wicware/multitool/00-documentation/02-img/glitch-voltage.png

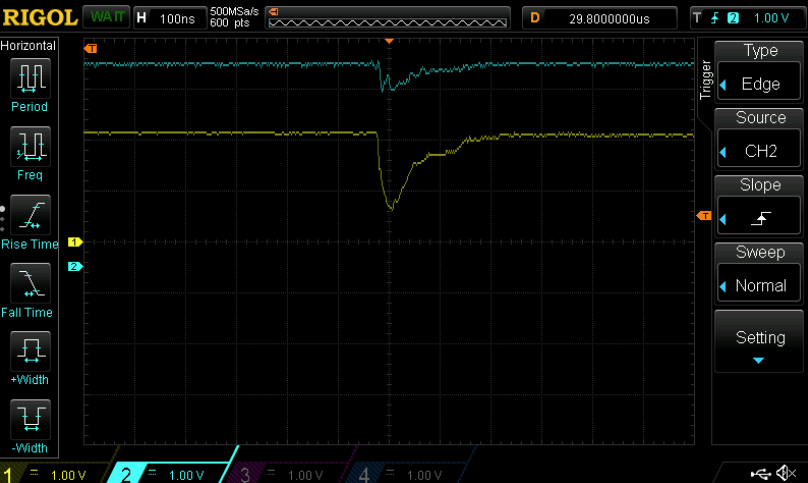
00-documentation/02-img/glitch-voltage.png
