wicware/multitool/00-documentation/image-1.png

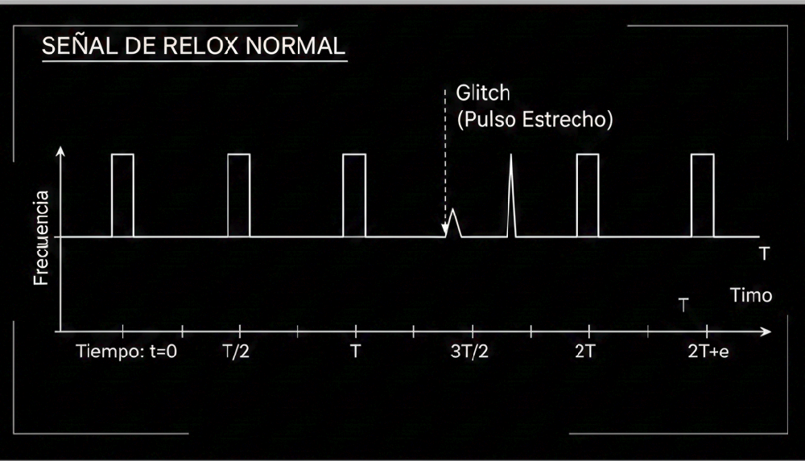
00-documentation/image-1.png
