wicware/multitool/02-hardware/FABRICATION/Sample-BOM_JLCSMT.xlsx

Comment | Designator | Footprint | JLCPCB Part #（optional）
47uF | C1 | Capacitor_SMD:C_1206_3216Metric
47uF | C2 | Capacitor_SMD:C_1206_3216Metric
47uF | C3 | Capacitor_SMD:C_1206_3216Metric
47uF | C4 | Capacitor_SMD:C_1206_3216Metric
47uF | C5 | Capacitor_SMD:C_1206_3216Metric
100nF | C6 | Capacitor_SMD:C_0603_1608Metric
1uF | C7 | Capacitor_SMD:C_0603_1608Metric
1uF | C8 | Capacitor_SMD:C_0603_1608Metric
100nF | C9 | Capacitor_SMD:C_0603_1608Metric
10uF | C10 | Capacitor_SMD:C_0603_1608Metric
100nF | C11 | Capacitor_SMD:C_0603_1608Metric
100nF | C12 | Capacitor_SMD:C_0603_1608Metric
100nF | C13 | Capacitor_SMD:C_0603_1608Metric
100nF | C14 | Capacitor_SMD:C_0603_1608Metric
100nF | C15 | Capacitor_SMD:C_0603_1608Metric
100nF | C16 | Capacitor_SMD:C_0603_1608Metric
8pF | C17 | Capacitor_SMD:C_0603_1608Metric
8pF | C18 | Capacitor_SMD:C_0603_1608Metric
100nF | C19 | Capacitor_SMD:C_0603_1608Metric
100nF | C20 | Capacitor_SMD:C_0603_1608Metric
100nF | C21 | Capacitor_SMD:C_0603_1608Metric
100nF | C22 | Capacitor_SMD:C_0603_1608Metric
100nF | C23 | Capacitor_SMD:C_0603_1608Metric
100nF | C24 | Capacitor_SMD:C_0603_1608Metric
1uF | C25 | Capacitor_SMD:C_0603_1608Metric
1uF | C26 | Capacitor_SMD:C_0603_1608Metric
100nF | C27 | Capacitor_SMD:C_0603_1608Metric
100nF | C28 | Capacitor_SMD:C_0603_1608Metric
YEL | D1 | LED_SMD:LED_0603_1608Metric
ORA | D2 | LED_SMD:LED_0603_1608Metric
PIN | D3 | LED_SMD:LED_0603_1608Metric
PRTR5V0U2X | D4 | Package_TO_SOT_SMD:SOT-143 | C5180302
GRE | D5 | LED_SMD:LED_0603_1608Metric
Fuse | F1 | Fuse:Fuse_1812_4532Metric | C142689
USB_C_Receptacle_USB2.0_16P | J1 | Connector_USB:USB_C_Receptacle_GCT_USB4105-xx-A_16P_TopMnt_Horizontal
AIN | J2 | Connector_PinHeader_2.54mm:PinHeader_1x03_P2.54mm_Vertical
GLITCH | J3 | Connector_PinHeader_2.54mm:PinHeader_1x03_P2.54mm_Vertical
ANA1 | J4 | Connector_PinHeader_2.54mm:PinHeader_1x04_P2.54mm_Vertical
ANA2 | J5 | Connector_PinHeader_2.54mm:PinHeader_1x04_P2.54mm_Vertical
ANA3 | J6 | Connector_PinHeader_2.54mm:PinHeader_1x04_P2.54mm_Vertical
GND | J7 | Connector_PinHeader_2.54mm:PinHeader_1x04_P2.54mm_Vertical
10uH | L1 | Inductor_SMD:L_Bourns_SRP7028A_7.3x6.6mm | C22463829
AO3400A | Q1 | Package_TO_SOT_SMD:SOT-223-3_TabPin2 | C20917
5.1k | R1 | Resistor_SMD:R_0603_1608Metric
5.1k | R2 | Resistor_SMD:R_0603_1608Metric
27k | R3 | Resistor_SMD:R_0603_1608Metric
2.7k | R4 | Resistor_SMD:R_0603_1608Metric
5.1k | R5 | Resistor_SMD:R_0603_1608Metric
5.1k | R6 | Resistor_SMD:R_0603_1608Metric
10 | R7 | Resistor_SMD:R_0603_1608Metric
22 | R8 | Resistor_SMD:R_0603_1608Metric
22 | R9 | Resistor_SMD:R_0603_1608Metric
10 | R10 | Resistor_SMD:R_0603_1608Metric
1k | R11 | Resistor_SMD:R_0603_1608Metric
470 | R12 | Resistor_SMD:R_0603_1608Metric
470 | R13 | Resistor_SMD:R_0603_1608Metric
470 | R14 | Resistor_SMD:R_0603_1608Metric
470 | R27 | Resistor_SMD:R_0603_1608Metric
C728722 | RN1 | Resistor_SMD:R_Array_Concave_4x0402 | C728722
C728722 | RN2 | Resistor_SMD:R_Array_Concave_4x0402 | C728722
C728722 | RN3 | Resistor_SMD:R_Array_Concave_4x0402 | C728722
TLV76133 | U1 | Package_TO_SOT_SMD:SOT-223-3_TabPin2 | C7527500
TLV76133 | U2 | Package_TO_SOT_SMD:SOT-223-3_TabPin2 | C7527500
LM358 | U3 | Package_SO:SO-8_3.9x4.9mm_P1.27mm | C693063
RP2040 | U4 | Package_DFN_QFN:QFN-56-1EP_7x7mm_P0.4mm_EP3.2x3.2mm
W25Q128JVS | U5 | Package_SO:SOIC-8_5.23x5.23mm_P1.27mm | C97521
MS9280 | U6 | Package_SO:SSOP-28_5.3x10.2mm_P0.65mm | C1509021
12MHz | Y1 | Crystal:Crystal_SMD_Abracon_ABM10-4Pin_2.5x2.0mm | C1985454
